Gugic/fanadapter/firmware-stm32/src/protocol.c

// Line-based JSON protocol over the console (USART1 + CDC) — the WebSerial contract. See protocol.h.
//
// Implements config, input/output telemetry, bench tests, direct output, DFU and USB diagnostics.
// get_config is streamed in chunks. Command/event
// shapes match webconfig/src/lib/{serial.ts,types.ts} and Fanadapter.Core/Protocol.cs.
#include "protocol.h"

#include <stdio.h>
#include <string.h>

#include "firmware_info.h"
#include "input_source.h"
#include "json_min.h"
#include "mapping.h"
#include "pedals.h"
#include "stm32h7xx_hal.h" // NVIC_SystemReset
#include "usb_input.h"     // usb_status / usb_kick diagnostics

extern int console_printf(const char *fmt, ...);
// Droppable variants — for the streaming telemetry events only. See console_emit() in main.c.
extern int console_event_printf(const char *fmt, ...);
extern int console_event_write(const char *s);

#define PROTO_VERSION    6 // 6: stream_axes (no-reply set_outputs variant for the PC pedal path)
#define LIVE_PERIOD_MS    33u // ~30 Hz; the console is the bottleneck (USART1 @115200 8E1)
#define OUTPUTS_PERIOD_MS 33u
#define MAX_GLOBAL_SLOTS  16u
#define MAX_TOP_KV        24
#define MAX_BIND_KV       16

static bool     g_live_inputs;
static bool     g_live_outputs;
static bool     g_shadow_connected[MAX_GLOBAL_SLOTS];
static uint32_t g_shadow_change[MAX_GLOBAL_SLOTS];
static uint32_t g_last_live_ms;
static uint32_t g_last_outputs_ms;

// ---------------- small response helpers --------------------------------------------------------
static void send_ok(void) { console_printf("{\"ok\":true}\r\n"); }
static void send_err(const char *msg) { console_printf("{\"err\":\"%s\"}\r\n", msg); }

// Escape a sanitized string for embedding in JSON (copy_string already stripped non-printables).
static void esc(const char *in, char *out, size_t outlen) {
  size_t o = 0;
  for (const char *p = in; *p && o < outlen - 2; p++) {
    if (*p == '"' || *p == '\\') out[o++] = '\\';
    out[o++] = *p;
  }
  out[o] = '\0';
}

// ---------------- type <-> name helpers ---------------------------------------------------------
static const char *input_type_name(uint8_t t) {
  switch (t) {
    case INPUT_BUTTON: return "button";
    case INPUT_AXIS: return "axis";
    case INPUT_HAT: return "hat";
    case INPUT_KEY: return "key";
    default: return "none";
  }
}
static uint8_t input_type_from_name(const char *s) {
  if (!s) return INPUT_NONE;
  if (!strcmp(s, "button")) return INPUT_BUTTON;
  if (!strcmp(s, "axis")) return INPUT_AXIS;
  if (!strcmp(s, "hat")) return INPUT_HAT;
  if (!strcmp(s, "key")) return INPUT_KEY;
  return INPUT_NONE;
}
static const char *gear_mode_name(uint8_t m) { return (m == GEAR_MODE_LATCH) ? "latch" : "hold"; }
static uint8_t     gear_mode_from_name(const char *s) {
  return (s && !strcmp(s, "latch")) ? GEAR_MODE_LATCH : GEAR_MODE_HOLD;
}

// Apply an optional uint16 binding field only when present, so partial set_binding edits are safe.
static void apply_u16(const json_kv *kv, int n, const char *key, uint16_t *dst) {
  long v;
  if (json_get_int(kv, n, key, &v)) *dst = (uint16_t)v;
}

// ---------------- command responses (FIFO-matched to the request) -------------------------------
static void cmd_version(void) {
  console_printf("{\"fw\":\"%s\",\"ver\":\"%s\",\"protocol\":%u,\"max_bindings_per_channel\":%u}\r\n",
                 FW_NAME, FW_VER, PROTO_VERSION, MAX_BINDINGS_PER_CHANNEL);
}

static void cmd_list_devices(void) {
  console_printf("{\"devices\":[");
  bool first = true;
  for (uint8_t si = 0; si < input_source_count(); si++) {
    const InputSource *src = input_source_get(si);
    uint8_t            cnt = src->device_count();
    for (uint8_t i = 0; i < cnt; i++) {
      InputDeviceInfo d;
      if (!src->device_info(i, &d)) continue;
      char mbuf[DEVICE_STR_LEN * 2], pbuf[DEVICE_STR_LEN * 2];
      esc(d.manufacturer, mbuf, sizeof(mbuf));
      esc(d.product, pbuf, sizeof(pbuf));
      console_printf("%s{\"slot\":%u,\"connected\":%s,\"vid\":%u,\"pid\":%u,\"manufacturer\":\"%s\","
                     "\"product\":\"%s\",\"axis_count\":%u,\"button_count\":%u,\"has_hat\":%s,"
                     "\"has_keyboard\":%s}",
                     first ? "" : ",", d.slot, d.connected ? "true" : "false", d.vid, d.pid, mbuf,
                     pbuf, d.axis_count, d.button_count, d.has_hat ? "true" : "false",
                     d.has_keyboard ? "true" : "false");
      first = false;
    }
  }
  console_printf("]}\r\n");
}

// get_config is ~8 KB of JSON — far larger than any single console buffer — so it is STREAMED as
// many small console_printf() chunks (each well under the 256-byte sink buffer). The USART1 leg
// waits for room only when USB is unmounted; with USB mounted it is a best-effort mirror.
// The CDC reply path drains with bounded backpressure (see console_printf).
static void emit_binding(const InputBinding *b) {
  console_printf("{\"vid\":%u,\"pid\":%u,\"type\":\"%s\",\"index\":%u,\"threshold\":%u,\"rawMin\":%u,"
                 "\"rawMax\":%u,\"deadzoneLow\":%u,\"deadzoneHigh\":%u,\"invert\":%s}",
                 b->vid, b->pid, input_type_name(b->type), b->index, b->threshold, b->rawMin,
                 b->rawMax, b->deadzoneLow, b->deadzoneHigh, b->invert ? "true" : "false");
}

static void emit_channel(const ChannelBindings *cb) {
  console_printf("[");
  for (uint8_t i = 0; i < MAX_BINDINGS_PER_CHANNEL; i++) {
    if (i) console_printf(",");
    emit_binding(&cb->bindings[i]);
  }
  console_printf("]");
}

static void cmd_get_config(void) {
  const Config *c = mapping_config();
  console_printf("{\"version\":%u,\"pulseMs\":%u,\"gearMode\":\"%s\",\"max_bindings_per_channel\":%u",
                 c->version, c->pulseMs, gear_mode_name(c->gearMode), MAX_BINDINGS_PER_CHANNEL);

  console_printf(",\"gear\":{");
  for (uint8_t i = 0; i < NUM_GEAR_BINDINGS; i++) {
    ChannelId ch = (ChannelId)(CH_GEAR_R + i);
    console_printf("%s\"%s\":", i ? "," : "", mapping_channel_name(ch));
    emit_channel(&c->gear[i]);
  }
  console_printf("}");

  console_printf(",\"gearOut\":{");
  for (uint8_t i = 0; i < NUM_GEAR_OUTPUTS; i++) {
    ChannelId ch = (ChannelId)(CH_GEAR_R + i);
    console_printf("%s\"%s\":{\"x\":%u,\"y\":%u}", i ? "," : "", mapping_channel_name(ch),
                   c->gearOut[i].x, c->gearOut[i].y);
  }
  console_printf("}");

  console_printf(",\"shift_up\":");
  emit_channel(&c->shiftUp);
  console_printf(",\"shift_down\":");
  emit_channel(&c->shiftDown);
  console_printf(",\"handbrake\":");
  emit_channel(&c->handbrake);
  console_printf(",\"throttle\":");
  emit_channel(&c->throttle);
  console_printf(",\"brake\":");
  emit_channel(&c->brake);
  console_printf(",\"clutch\":");
  emit_channel(&c->clutch);
  console_printf("}\r\n");
}

static void cmd_set_binding(const json_kv *kv, int n) {
  char ch_name[16];
  if (!json_get_str(kv, n, "channel", ch_name, sizeof(ch_name))) {
    send_err("missing_channel");
    return;
  }
  ChannelId ch   = mapping_channel_by_name(ch_name);
  long      slot = 0;
  json_get_int(kv, n, "slot", &slot); // optional, defaults to 0
  if (slot < 0 || slot >= MAX_BINDINGS_PER_CHANNEL) {
    send_err("invalid_slot");
    return;
  }
  InputBinding *b = mapping_binding_slot(ch, (uint8_t)slot);
  if (!b) {
    send_err("unknown_channel_or_slot");
    return;
  }
  const json_kv *bind = json_find(kv, n, "binding");
  if (!bind || bind->type != JSON_OBJ) {
    send_err("missing_binding");
    return;
  }
  json_kv bkv[MAX_BIND_KV];
  int     nb = json_parse_object(bind->val, bind->vallen, bkv, MAX_BIND_KV);
  if (nb < 0) {
    send_err("bad_binding");
    return;
  }
  if (nb > MAX_BIND_KV) nb = MAX_BIND_KV;

  apply_u16(bkv, nb, "vid", &b->vid);
  apply_u16(bkv, nb, "pid", &b->pid);
  char type_name[12];
  if (json_get_str(bkv, nb, "type", type_name, sizeof(type_name)))
    b->type = input_type_from_name(type_name); // "none" -> INPUT_NONE clears the slot
  long idx;
  if (json_get_int(bkv, nb, "index", &idx) && idx >= 0 && idx <= 255) b->index = (uint8_t)idx;
  apply_u16(bkv, nb, "threshold", &b->threshold);
  apply_u16(bkv, nb, "rawMin", &b->rawMin);
  apply_u16(bkv, nb, "rawMax", &b->rawMax);
  apply_u16(bkv, nb, "deadzoneLow", &b->deadzoneLow);
  apply_u16(bkv, nb, "deadzoneHigh", &b->deadzoneHigh);
  int inv = json_get_bool(bkv, nb, "invert");
  if (inv >= 0) b->invert = inv ? 1 : 0;

  mapping_recompute_crc();
  send_ok();
}

static void cmd_set_gear_dac(const json_kv *kv, int n) {
  char ch_name[16];
  if (!json_get_str(kv, n, "channel", ch_name, sizeof(ch_name))) {
    send_err("missing_channel");
    return;
  }
  GearOutputCalibration *g = mapping_gearout_for(mapping_channel_by_name(ch_name));
  if (!g) {
    send_err("not_a_gear_channel");
    return;
  }
  apply_u16(kv, n, "x", &g->x);
  apply_u16(kv, n, "y", &g->y);
  mapping_recompute_crc();
  send_ok();
}

static void cmd_set_pulse_ms(const json_kv *kv, int n) {
  long v;
  if (!json_get_int(kv, n, "value", &v)) {
    send_err("missing_value");
    return;
  }
  mapping_config_mutable()->pulseMs = (uint16_t)v;
  mapping_recompute_crc();
  send_ok();
}

static void cmd_set_gear_mode(const json_kv *kv, int n) {
  char v[12];
  if (!json_get_str(kv, n, "value", v, sizeof(v))) {
    send_err("missing_value");
    return;
  }
  mapping_config_mutable()->gearMode = gear_mode_from_name(v);
  mapping_recompute_crc();
  send_ok();
}

static void cmd_save_config(void) {
  if (mapping_save()) send_ok();
  else send_err("flash_save_failed");
}

static void cmd_reset_config(void) {
  mapping_reset();
  send_ok();
}

static void cmd_live_inputs(const json_kv *kv, int n) {
  int on = json_get_bool(kv, n, "on");
  if (on >= 0) g_live_inputs = (on == 1);
  send_ok();
}

static void cmd_live_outputs(const json_kv *kv, int n) {
  int on = json_get_bool(kv, n, "on");
  if (on >= 0) g_live_outputs = (on == 1);
  send_ok();
}

static void cmd_test_gear(const json_kv *kv, int n) {
  char ch_name[16];
  if (!json_get_str(kv, n, "channel", ch_name, sizeof(ch_name))) {
    send_err("missing_channel");
    return;
  }
  ChannelId ch = mapping_channel_by_name(ch_name);
  if (ch < CH_GEAR_R || ch > CH_GEAR_N) {
    send_err("not_a_gear_channel");
    return;
  }
  mapping_test_gear(ch);
  send_ok();
}

// --- direct output control --------------------------------------------------------------------
// The PC (SimHub / the web app) computes its own mapping and commands the adapter's outputs. These
// override the USB-device mapping for the channels they touch (sticky until release_outputs). set_gear
// and set_outputs are acknowledged and must consume their replies. Only stream_axes is no-reply
// and may use a fire-and-forget write for the protocol-6 pedal/handbrake hot path.
static void cmd_set_gear(const json_kv *kv, int n) {
  char gear[16];
  if (!json_get_str(kv, n, "gear", gear, sizeof(gear))) {
    send_err("missing_gear");
    return;
  }
  ChannelId ch = mapping_channel_by_name(gear);
  if (ch < CH_GEAR_R || ch > CH_GEAR_N) {
    send_err("not_a_gear");
    return;
  }
  mapping_set_gear_override(ch);
  send_ok();
}

static void cmd_set_outputs(const json_kv *kv, int n) {
  long v;
  if (json_get_int(kv, n, "throttle", &v)) mapping_set_axis_override(CH_THROTTLE, (uint16_t)v);
  if (json_get_int(kv, n, "brake", &v)) mapping_set_axis_override(CH_BRAKE, (uint16_t)v);
  if (json_get_int(kv, n, "clutch", &v)) mapping_set_axis_override(CH_CLUTCH, (uint16_t)v);
  if (json_get_int(kv, n, "handbrake", &v)) mapping_set_axis_override(CH_HANDBRAKE, (uint16_t)v);
  send_ok();
}

// No-reply variant of set_outputs for the PC-side pedal hot path (protocol 6). An acked command
// costs a full round-trip per update — measured 7.9 ms over native CDC, capping an ack-waiting
// streamer at ~127 Hz and adding the ack wait as jitter. Pedals deserve neither, so this one
// answers NOTHING: the client fires it at its own fixed rate and never blocks. No reply also
// means it never enters the clients' strictly-FIFO reply matching, so a stream frame can never
// desync command/response pairing. Axes only — gears stay on the acked set_gear (low-rate, and
// the confirmation matters there). Same sticky-override semantics as set_outputs.
static void cmd_stream_axes(const json_kv *kv, int n) {
  long v;
  if (json_get_int(kv, n, "throttle", &v)) mapping_set_axis_override(CH_THROTTLE, (uint16_t)v);
  if (json_get_int(kv, n, "brake", &v)) mapping_set_axis_override(CH_BRAKE, (uint16_t)v);
  if (json_get_int(kv, n, "clutch", &v)) mapping_set_axis_override(CH_CLUTCH, (uint16_t)v);
  if (json_get_int(kv, n, "handbrake", &v)) mapping_set_axis_override(CH_HANDBRAKE, (uint16_t)v);
}

static void cmd_pulse_shift(const json_kv *kv, int n) {
  char dir[8];
  if (!json_get_str(kv, n, "direction", dir, sizeof(dir))) {
    send_err("missing_direction");
    return;
  }
  if (!strcmp(dir, "up")) mapping_pulse_shift(true);
  else if (!strcmp(dir, "down")) mapping_pulse_shift(false);
  else {
    send_err("invalid_direction");
    return;
  }
  send_ok();
}

static void cmd_release_outputs(void) {
  mapping_release_outputs();
  send_ok();
}

// --- test / maintenance (M7) -------------------------------------------------------------------
static void cmd_test_axis(const json_kv *kv, int n) {
  char ch_name[16];
  if (!json_get_str(kv, n, "channel", ch_name, sizeof(ch_name))) {
    send_err("missing_channel");
    return;
  }
  ChannelId ch = mapping_channel_by_name(ch_name);
  if (ch != CH_HANDBRAKE && ch != CH_THROTTLE && ch != CH_BRAKE && ch != CH_CLUTCH) {
    send_err("not_an_axis_channel");
    return;
  }
  long v = 0;
  json_get_int(kv, n, "value", &v); // optional, defaults to 0
  mapping_test_axis(ch, (uint16_t)v);
  send_ok();
}

static void cmd_test_pulse(const json_kv *kv, int n) {
  char dir[8];
  if (!json_get_str(kv, n, "direction", dir, sizeof(dir))) {
    send_err("missing_direction");
    return;
  }
  if (!strcmp(dir, "up")) mapping_test_pulse(true);
  else if (!strcmp(dir, "down")) mapping_test_pulse(false);
  else {
    send_err("invalid_direction");
    return;
  }
  send_ok();
}

// Soft-reset back into this firmware (SYSRESETREQ). Surviving the wheelbase's pedal-UART state, so a
// reset_pedals re-arm is often still needed after — the warmup helps. The ok is flushed first.
static void cmd_reboot(void) {
  send_ok();
  for (volatile uint32_t d = 0; d < 800000u; d++) __NOP(); // let the ok + any CDC FIFO drain
  NVIC_SystemReset();
}

// Reboot into the ROM bootloader (USB DFU on the USB-C) via the token + reset + early-branch path
// in main.c — the CDC port disappears and a DFU device (0483:df11) appears in its place. Used by
// the browser and SimHub firmware flashers. The ok is flushed first — the client's cue to watch for
// the DFU device.
extern void request_bootloader_reboot(void);
static void cmd_dfu(void) {
  send_ok();
  for (volatile uint32_t d = 0; d < 800000u; d++) __NOP(); // let the ok + any CDC FIFO drain
  request_bootloader_reboot();
}

static void cmd_reset_pedals(void) {
  pedals_force_reset();
  send_ok();
}

static void cmd_pedals_status(void) {
  console_printf("{\"state\":\"%s\",\"throttle\":%u,\"brake\":%u,\"clutch\":%u,\"handbrake\":%u}\r\n",
                 pedals_state_name(), pedals_get_throttle(), pedals_get_brake(), pedals_get_clutch(),
                 pedals_get_handbrake());
}

// USB-host pipe diagnostics for the open field bug: a hub device goes silent while still
// enumerated, freezing its last values. These interrogate a freeze in the act. `usb_status`
// snapshots each claimed slot's pipe (busy = transfer outstanding — healthy devices near-always
// are, since a device with nothing to say NAKs; the tell is `age_ms` growing on a device the user
// is actively moving). `usb_kick` aborts + re-arms every claimed pipe: if inputs resume, the wedge
// was host-side (a dwc2 channel stuck busy); if not, the device itself stopped talking. Both
// Commands reply in chunks on the intact console path, like get_config.
// Raw dwc2 host-controller registers on OTG_HS, read directly for the freeze discriminator —
// no TinyUSB internals needed. HCCHAR carries the device address + endpoint each channel is bound
// to, so a frozen slot (matched by "da") can be looked up in the channel dump:
//   ena:0 on its channel  -> Cause A: token post silently swallowed, channel never enabled
//   ena:1 on its channel  -> Cause B: DTERR dead-end (check hcint), or the device itself hung
//   no channel with its da -> Cause C: alloc race orphaned the endpoint
// (candidate causes and code refs: PORT-STATUS "three surviving candidate causes")
// Patched into the vendored hcd_dwc2.c by apply_tinyusb_patches.py:
extern uint32_t tusb_fanadapter_reqq_fail_token;
extern uint32_t tusb_fanadapter_reqq_fail_disable;
extern uint32_t tusb_fanadapter_alloc_mask(void);

#define OTGHS_HPTXSTS   (*(volatile uint32_t *)(USB1_OTG_HS_PERIPH_BASE + 0x410u))
#define OTGHS_HCCHAR(c) (*(volatile uint32_t *)(USB1_OTG_HS_PERIPH_BASE + 0x500u + (c) * 0x20u))
#define OTGHS_HCINT(c)  (*(volatile uint32_t *)(USB1_OTG_HS_PERIPH_BASE + 0x508u + (c) * 0x20u))
#define OTGHS_HOST_CHANNELS 16u

static void cmd_usb_status(void) {
  console_printf("{\"uptime_ms\":%lu,\"slots\":[", (unsigned long)HAL_GetTick());
  bool first = true;
  for (uint8_t i = 0; i < USB_POOL_SIZE; i++) {
    UsbSlotDiag d;
    if (!usb_input_diag(i, &d) || !d.in_use) continue;
    console_printf("%s{\"slot\":%u,\"vid\":%u,\"pid\":%u,\"da\":%u,\"mounted\":%s,\"busy\":%s,"
                   "\"reports\":%lu,\"age_ms\":%lu,\"idle_rearms\":%lu}",
                   first ? "" : ",", i, d.vid, d.pid, d.daddr, d.mounted ? "true" : "false",
                   d.busy ? "true" : "false", (unsigned long)d.reports, (unsigned long)d.age_ms,
                   (unsigned long)d.idle_rearms);
    first = false;
  }
  // hptx: HPTXSTS — low 16 bits = periodic TX FIFO space, bits 16..23 = request-queue space
  // (the silent failures fire when request-queue space reads 0 at a channel-op instant).
  // reqq_fail_*: counters patched into hcd_dwc2.c (apply_tinyusb_patches.py) — nonzero says WHICH
  // queue-full path fired. alloc_mask: which channels the driver believes are allocated — the key
  // for telling a wedged allocated-but-disabled channel from a freed one with stale HCCHAR.
  console_printf("],\"hptx\":%lu,\"reqq_fail_token\":%lu,\"reqq_fail_disable\":%lu,"
                 "\"alloc_mask\":%lu,\"channels\":[",
                 (unsigned long)OTGHS_HPTXSTS, (unsigned long)tusb_fanadapter_reqq_fail_token,
                 (unsigned long)tusb_fanadapter_reqq_fail_disable,
                 (unsigned long)tusb_fanadapter_alloc_mask());
  first = true;
  for (uint8_t c = 0; c < OTGHS_HOST_CHANNELS; c++) {
    uint32_t hcchar = OTGHS_HCCHAR(c);
    if (!hcchar) continue; // never-programmed channel
    console_printf("%s{\"ch\":%u,\"da\":%lu,\"ep\":%lu,\"in\":%u,\"ena\":%u,\"dis\":%u,"
                   "\"hcint\":%lu}",
                   first ? "" : ",", c, (unsigned long)((hcchar >> 22) & 0x7Fu),
                   (unsigned long)((hcchar >> 11) & 0x0Fu), (unsigned)((hcchar >> 15) & 1u),
                   (unsigned)((hcchar >> 31) & 1u), (unsigned)((hcchar >> 30) & 1u),
                   (unsigned long)OTGHS_HCINT(c));
    first = false;
  }
  console_printf("]}\r\n");
}

// Diagnostic reproducer for the freeze's suspected trigger: skip tuh_task() for N ms while the
// rest of the loop (pedals, mapping, console) keeps running — surgically simulating what a long
// main-loop stall does to the USB host stack, without involving the console at all. If repeated
// stalls freeze the streaming pedal on demand, the bug gains a bench reproducer.
extern void usb_host_stall_for(uint32_t ms);
static void cmd_usb_stall(const json_kv *kv, int n) {
  long ms = 1000;
  json_get_int(kv, n, "ms", &ms);
  if (ms < 1) ms = 1;
  if (ms > 10000) ms = 10000;
  usb_host_stall_for((uint32_t)ms);
  console_printf("{\"ok\":true,\"ms\":%ld}\r\n", ms);
}

static void cmd_usb_kick(void) {
  uint32_t aborted = usb_input_kick();
  console_printf("{\"ok\":true,\"aborted_mask\":%lu}\r\n", (unsigned long)aborted);
}

// ---------------- events ------------------------------------------------------------------------
static void emit_attached(const InputDeviceInfo *d) {
  char mbuf[DEVICE_STR_LEN * 2], pbuf[DEVICE_STR_LEN * 2];
  esc(d->manufacturer, mbuf, sizeof(mbuf));
  esc(d->product, pbuf, sizeof(pbuf));
  console_printf(
      "{\"event\":\"device_attached\",\"slot\":%u,\"vid\":%u,\"pid\":%u,\"manufacturer\":\"%s\","
      "\"product\":\"%s\",\"axis_count\":%u,\"button_count\":%u,\"has_hat\":%s,\"has_keyboard\":%s}"
      "\r\n",
      d->slot, d->vid, d->pid, mbuf, pbuf, d->axis_count, d->button_count,
      d->has_hat ? "true" : "false", d->has_keyboard ? "true" : "false");
}

static void emit_detached(uint8_t slot) {
  console_printf("{\"event\":\"device_detached\",\"slot\":%u}\r\n", slot);
}

// The two streaming events go out on the DROPPABLE console path. They are superseded ~30 times a
// second, so losing one when the sink is congested costs nothing — whereas waiting for one costs
// the 100 Hz pedal stream its cadence, which is what used to freeze inputs and make gear changes
// arrive a minute late. Command responses keep using console_printf and still arrive intact.
static void emit_outputs(void) {
  const OutputSnapshot *o = mapping_outputs();
  console_event_printf("{\"event\":\"outputs\",\"gear\":\"%s\",\"shift_up\":%s,\"shift_down\":%s,"
                       "\"throttle\":%u,\"brake\":%u,\"clutch\":%u,\"handbrake\":%u}\r\n",
                       mapping_channel_name(o->gear), o->shiftUp ? "true" : "false",
                       o->shiftDown ? "true" : "false", o->throttle, o->brake, o->clutch,
                       o->handbrake);
}

static void emit_live(const InputLive *lv) {
  // Assembled into ONE buffer and emitted atomically. Each console_event_* call drops
  // independently when congested, so building this line in pieces (as it used to be) could drop a
  // fragment mid-line and put malformed JSON on the wire.
  char b[320];
  int  n = 0;
#define LIVE_APPEND(...)                                                       \
  do {                                                                         \
    if (n < 0 || (size_t)n >= sizeof(b)) return;                               \
    int _r = snprintf(b + n, sizeof(b) - (size_t)n, __VA_ARGS__);              \
    if (_r < 0) return;                                                        \
    n += _r;                                                                   \
  } while (0)

  LIVE_APPEND("{\"event\":\"live\",\"slot\":%u,\"buttons\":%lu,\"axes\":[", lv->slot,
              (unsigned long)lv->buttons);
  for (uint8_t a = 0; a < lv->axis_count && a < INPUT_MAX_AXES; a++)
    LIVE_APPEND("%s%u", a ? "," : "", lv->axes[a]);
  LIVE_APPEND("]");
  if (lv->has_hat) LIVE_APPEND(",\"hat\":%d", (lv->hat == INPUT_HAT_RELEASED) ? -1 : (int)lv->hat);
  if (lv->has_keyboard) {
    LIVE_APPEND(",\"keys\":[");
    for (uint8_t k = 0; k < INPUT_MAX_KEYS; k++) LIVE_APPEND("%s%u", k ? "," : "", lv->keys[k]);
    LIVE_APPEND("]");
  }
  LIVE_APPEND("}\r\n");
#undef LIVE_APPEND

  console_event_write(b);
}

// ---------------- dispatch ----------------------------------------------------------------------
void protocol_handle_line(const char *line) {
  if (line[0] != '{') return; // non-JSON lines are the bring-up CLI (handled in main.c)
  json_kv kv[MAX_TOP_KV];
  int     n = json_parse_object(line, strlen(line), kv, MAX_TOP_KV);
  if (n < 0) {
    send_err("bad_json");
    return;
  }
  if (n > MAX_TOP_KV) n = MAX_TOP_KV;

  char cmd[24];
  if (!json_get_str(kv, n, "cmd", cmd, sizeof(cmd))) {
    send_err("missing_cmd");
    return;
  }

  if (!strcmp(cmd, "version")) cmd_version();
  else if (!strcmp(cmd, "list_devices")) cmd_list_devices();
  else if (!strcmp(cmd, "get_config")) cmd_get_config();
  else if (!strcmp(cmd, "set_binding")) cmd_set_binding(kv, n);
  else if (!strcmp(cmd, "set_gear_dac")) cmd_set_gear_dac(kv, n);
  else if (!strcmp(cmd, "set_pulse_ms")) cmd_set_pulse_ms(kv, n);
  else if (!strcmp(cmd, "set_gear_mode")) cmd_set_gear_mode(kv, n);
  else if (!strcmp(cmd, "save_config")) cmd_save_config();
  else if (!strcmp(cmd, "reset_config")) cmd_reset_config();
  else if (!strcmp(cmd, "live_inputs")) cmd_live_inputs(kv, n);
  else if (!strcmp(cmd, "live_outputs")) cmd_live_outputs(kv, n);
  else if (!strcmp(cmd, "test_gear")) cmd_test_gear(kv, n);
  else if (!strcmp(cmd, "set_gear")) cmd_set_gear(kv, n);
  else if (!strcmp(cmd, "set_outputs")) cmd_set_outputs(kv, n);
  else if (!strcmp(cmd, "stream_axes")) cmd_stream_axes(kv, n);
  else if (!strcmp(cmd, "pulse_shift")) cmd_pulse_shift(kv, n);
  else if (!strcmp(cmd, "release_outputs")) cmd_release_outputs();
  else if (!strcmp(cmd, "test_axis")) cmd_test_axis(kv, n);
  else if (!strcmp(cmd, "test_pulse")) cmd_test_pulse(kv, n);
  else if (!strcmp(cmd, "reboot")) cmd_reboot();
  else if (!strcmp(cmd, "dfu")) cmd_dfu();
  else if (!strcmp(cmd, "reset_pedals")) cmd_reset_pedals();
  else if (!strcmp(cmd, "pedals_status")) cmd_pedals_status();
  else if (!strcmp(cmd, "usb_status")) cmd_usb_status();
  else if (!strcmp(cmd, "usb_kick")) cmd_usb_kick();
  else if (!strcmp(cmd, "usb_stall")) cmd_usb_stall(kv, n);
  else send_err("unknown_cmd");
}

void protocol_init(void) {
  g_live_inputs  = false;
  g_live_outputs = false;
  memset(g_shadow_connected, 0, sizeof(g_shadow_connected));
  memset(g_shadow_change, 0, sizeof(g_shadow_change));
}

void protocol_tick(uint32_t now_ms) {
  // Attach/detach: diff connected state per global slot. Shadows always track; emit only when streaming.
  for (uint8_t si = 0; si < input_source_count(); si++) {
    const InputSource *src = input_source_get(si);
    uint8_t            cnt = src->device_count();
    for (uint8_t i = 0; i < cnt; i++) {
      InputDeviceInfo d;
      if (!src->device_info(i, &d) || d.slot >= MAX_GLOBAL_SLOTS) continue;
      if (d.connected != g_shadow_connected[d.slot]) {
        g_shadow_connected[d.slot] = d.connected;
        if (g_live_inputs) {
          if (d.connected) emit_attached(&d);
          else emit_detached(d.slot);
        }
      }
    }
  }

  // Live outputs — current output snapshot, rate-limited.
  if (g_live_outputs && (uint32_t)(now_ms - g_last_outputs_ms) >= OUTPUTS_PERIOD_MS) {
    g_last_outputs_ms = now_ms;
    emit_outputs();
  }

  if (!g_live_inputs || (uint32_t)(now_ms - g_last_live_ms) < LIVE_PERIOD_MS) return;
  g_last_live_ms = now_ms;
  for (uint8_t si = 0; si < input_source_count(); si++) {
    const InputSource *src = input_source_get(si);
    uint8_t            cnt = src->device_count();
    for (uint8_t i = 0; i < cnt; i++) {
      InputLive lv;
      if (!src->device_live(i, &lv) || !lv.connected || lv.slot >= MAX_GLOBAL_SLOTS) continue;
      if (lv.change_seq != g_shadow_change[lv.slot]) {
        g_shadow_change[lv.slot] = lv.change_seq;
        emit_live(&lv);
      }
    }
  }
}
