Gugic/fanadapter/(commit log)

2026-05-22 Working pedals end-to-end on DD+; SP Pro HID; doc cleanup
    Pedal handshake (pedals.cpp):
    - Replace strict-linear Step 2 matcher with a lenient any-order
    packet collector. The DD+ firmware sends the three Step 2 query
    packets (cmd 0x00, 0x02, 0x03) in arbitrary order, sometimes
    dozens of times each, and with a different 0x02 payload than
    the GeekyDeaks/proxy.go reference. Strict matching never
    completes; matches the community sketch in GeekyDeaks#4.
    - Per-query streaming responses instead of one 36-byte bulk write.
    Each cmd gets its 12-byte ack the instant it's recognized.
    - Transition to STREAMING after the cmd 0x03 ack (the version-
    identity packet) rather than waiting for all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
    [pedals.cpp, pedals.h]
2026-05-26 Runtime-configurable mappings, WebSerial config UI, multi-input per channel
    Firmware (shifter_test/):
    - Split the monolithic .ino into device_pool / mapping / protocol modules;
    pedals.cpp remains the CSL Elite V2 UART emulator.
    - 1060-byte Config struct persisted to EEPROM with CRC-32/ISO-HDLC,
    static_assert-locked layout, CONFIG_VERSION = 2.
    - Each of the 14 output channels (8 gears, 2 sequential, handbrake,
    3 pedals) now carries up to MAX_BINDINGS_PER_CHANNEL = 4 input bindings;
    buttons OR together, axes MAX together. Cross-type aware: axis-as-button
    via post-scale threshold, button-as-axis emits 0/65535.
    - JSON command protocol over USB CDC: version, list_devices, get_config,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
    [device_pool.cpp, device_pool.h, mapping.cpp, mapping.h, pedals.cpp, pedals.h, protocol.cpp, protocol.h]
2026-05-26 Rename shifter_test/ to firmware/
    The original prototype name no longer reflects the project (which covers
    pedals, sequential, handbrake, and the WebSerial config story, not just
    H-shifter testing). All paths git-mv'd so history follows; .ino renamed
    to firmware.ino to keep the Arduino sketch/folder-name convention. Two
    README references updated.
    [device_pool.cpp, device_pool.h, firmware.ino, mapping.cpp, mapping.h, pedals.cpp, pedals.h, protocol.cpp]
2026-05-26 Add AI coding-agent instructions (AGENTS.md, CLAUDE.md)
    AGENTS.md is the canonical agent guide: repo layout, firmware module map, cross-file invariants (firmware <-> webconfig), channel model, capture flow, serial protocol queue, and a checklist of things agents should know before editing. CLAUDE.md is a pointer so Claude Code loads it automatically.
    .gitignore: add .antigravitycli/ alongside the existing .claude/ entry — both are local AI-agent session artifacts that should stay out of version control.
2026-05-26 Fix multi-binding overwrite bug by replacing strict ArduinoJson is<uint8_t/uint16_t> checks with robust is<int>
    On the Teensy compiler and with this version of ArduinoJson, calling .is<uint8_t>() or .is<uint16_t>() strictly checks type traits or can fail to match JSON integer storage. Specifically, this caused doc["slot"].is<uint8_t>() to return false, defaulting slot to 0 on every set_binding call. As a result, mapping a trigger to slot 1, 2, or 3 silently overwrote slot 0, making it look like the firmware only caught the last mapped trigger.
    Replacing all sub-word integer .is<uint8_t>() and .is<uint16_t>() checks in protocol.cpp with the standard and compiler-independent .is<int>() check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
    [protocol.cpp]
2026-05-26 Add custom USB descriptors to rename device to Fanadapter v0.3.0
    Added name.c inside the firmware folder, utilizing Teensyduino's usb_names.h to override the weak USB manufacturer and product string descriptors. This replaces the generic "USB Serial (COM11)" name with Manufacturer: "fanadapter" and Product: "Fanadapter v0.3.0" (matching the current firmware version).
    Updated AGENTS.md and firmware/README.md to document the addition of the name.c translation unit in the module architecture list.
    [name.c]
2026-05-26 Fix Teensy USB name override by adding PROGMEM to descriptor structures
    Without PROGMEM, the compiler puts the custom structures in standard RAM instead of flash memory, which fails to match the core usb_names.h declarations and prevents the weak symbols from being successfully overridden at link time.
    [name.c]
2026-05-26 Add Gamepad and Multi-axis Controller support to the device pool
    Added support for TOPUSAGE_GAMEPAD (0x10005) and TOPUSAGE_MULTIAXIS (0x10008) in device_pool.h/cpp, letting the GenericJoystickHID slots claim standard gamepads (such as Xbox, PlayStation, or generic controllers) and multi-axis devices in addition to generic joysticks.
    Updated AGENTS.md and firmware/README.md to reflect gamepad/controller support.
2026-05-26 Implement multi-device HID collection logging to capture diagnostic info
    Replaced the single-field unhandled device tracker with a robust, thread-safe circular buffer (up to 16 entries) inside device_pool.cpp. The USB Host task now silently registers all observed HID collections (both whitelisted and vendor-specific) to this buffer during device enumeration.
    The main loop thread (inside protocolTick() in protocol.cpp) safely polls, prints, and clears the logged entries to the Serial CDC output whenever a connection is active. This avoids any re-entrant locks on the USB hardware while ensuring we capture all HID collections for the DualSense controller.
    [device_pool.cpp, device_pool.h, protocol.cpp]
2026-05-27 Add D-pad, keyboard, and latch-mode H-pattern input support (#2)
    Expands the input layer beyond joysticks/gamepads with two new first-class
    input types and a stateful H-pattern mode for momentary controllers.
    Firmware:
    - INPUT_HAT: gamepad D-pad / Hat Switch decoded as a first-class direction
    value (0..7, HAT_RELEASED=0xFF), not virtual buttons. Bindings match a
    strict direction; diagonals don't fire cardinal bindings. evalAxis /
    evalButton handle it with invert support.
    - INPUT_KEY: claim USB keyboards (topusage 0x10006) into the device pool,
    track up to MAX_KEYS_PRESSED (6) pressed scancodes, bind any key
    (incl. modifiers 0xE0..0xE7) via the normal Listen flow.
    - H-pattern hold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
    [device_pool.cpp, device_pool.h, firmware.ino, mapping.cpp, mapping.h, protocol.cpp]
2026-05-27 Restructure and organize project documentation (#1)
    * docs: restructure repository documentation
    - Created high-level root README.md with system overview, compatibility, layout, roadmap, references, and license.
    - Created schematics/README.md for hardware port pinouts, protocols, BoM, step-by-step assembly, and block diagrams.
    - Refined firmware/README.md to focus on compiling/flashing, loop dispatch module layout, internal logic, serial diagnostic CLI, and JSON API reference.
    - Refined webconfig/README.md to focus on React/Vite development, three-phase capture flow, FIFO serial queue, cross-file invariants, and presets config.
    * docs: fold D-pad/keyboard/latch inputs into restructured ref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
2026-05-27 Device names in enumeration + streamlined mapping UI (#3)
    * feat: surface USB device names in enumeration
    Capture each device's USB manufacturer/product string descriptors at
    claim time (sanitised to printable ASCII so the protocol JSON stays
    valid UTF-8) and emit them in list_devices and device_attached. The
    strings are read straight from dev->strbuf, which enumeration populates
    before claim_collection() runs, so binding mydevice plus the inherited
    product() accessor is enough.
    Lets the configurator label devices by name instead of raw VID/PID.
    * feat: streamline webconfig mapping UI
    - Show device names (manufacturer/product) on device cards and in
    binding summaries, falling back to V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
    [device_pool.cpp, device_pool.h, firmware.ino, protocol.cpp]
2026-05-28 chore: drop orphan preset file + corresponding README section (#14)
    webconfig/public/presets/rs-shifter-rs-combo-spu-spro.json was never
    loaded by any code — no fetch, no import, no UI surface. The README
    described public/presets/ as 'Pre-bundled JSON configurations loaded
    via fetch' but that loading code was never written. This PR was even
    growing the file (196+/14-) without anything consuming it.
    Drops both the file and the corresponding README section (the public/
    directory listing and the 'Presets Config Layout' / 'Standard Presets'
    sections). If we ever wire up preset loading, the file can come back
    alongside the code that consumes it.
2026-07-20 STM32H743 port: full-parity C firmware with native USB webconfig (#22)
2026-07-20 STM32: record full end-to-end validation on the WeAct H743VIT6 (#23)
2026-07-20 docs: split the STM32 port docs into a build guide and a dev record (#24)
2026-07-21 STM32: watchdog for silently dropped HID report pipes
    Field symptom: after a few minutes the USB pedals stopped delivering input
    while still listed as connected; every other hub device kept working; only a
    reboot recovered it, and only for a few minutes.
    TinyUSB never re-arms a report pipe itself — the only thing keeping a device
    polling is the tuh_hid_receive_report() call at the end of the report
    callback, and that call can fail transiently (endpoint claim / host channel
    allocation). Both call sites ignored the return value, so a single failure
    permanently silenced the device while the pool slot, list_devices and the
    mount state all stayed healthy. It hits the pedals first because analo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
    [main.c]
2026-07-21 STM32: make hands-free DFU entry actually work (token + reset + early branch)
    The advertised "hands-free" dfu console command had never been validated and
    wedged the board every time: it clock-gated the OTG controllers and branched
    to the ROM from the running app. The clock gate froze the D+ pullup latched
    high, so the host never saw a detach — Windows kept a zombie COM port that
    failed opens with "device not functioning" — and no DFU device ever appeared.
    Only an RST tap recovered.
    Bisected on hardware: a late software branch into the H7 ROM serves NO
    interfaces at all. Not USART (June, FK743M3 — previously mistaken for
    "USB-only mode") and not USB DFU either: adding a proper tud_dis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
    [main.c]
2026-07-21 STM32: stop logging from the main loop; record the real cause of input freezes
    The watchdog added in #26 aimed at the wrong failure, and the field
    evidence says the whole USB-host theory was wrong.
    What actually starves the adapter is console_printf. It does a blocking
    HAL_UART_Transmit per line whether or not anything is attached to USART1,
    and the live/outputs telemetry events are emitted through it: ~5.5 ms per
    live line and ~10.5 ms per outputs line at 115200 8E1, with inputs at up
    to ~30 Hz and outputs streaming continuously. With both streams enabled —
    which is exactly what webconfig and the SimHub plugin do on connect — over
    half of every second is spent blocked, in a loop where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
    [main.c]
2026-07-21 STM32: JSON {"cmd":"dfu"} — reboot to bootloader as a protocol command
    The dfu console verb becomes reachable as a JSON command so clients can
    drive a firmware update without a terminal: ok is flushed first (the
    client's cue to start watching USB for the DFU device), then the token +
    reset + early-branch path runs. STM32-only by nature; the Teensy answers
    unknown_cmd, same as the direct-output commands.
    Hardware-validated on COM10: {"cmd":"dfu"} -> {"ok":true} -> CDC drops ->
    "DFU in FS Mode" enumerates.
    [main.c, protocol.c]
2026-07-21 webconfig: one-click firmware updates, with the Pages deploy as the channel
    The header's Flash button opens an updater that runs the whole cycle from
    one press: fetch the published image, reboot the adapter into its ROM
    bootloader over serial, find the DFU device through the persisted WebUSB
    grant, erase/write/boot over DfuSe (src/lib/dfu.ts), reconnect through the
    persisted WebSerial grant, confirm the new version. Chromium's device
    picker appears exactly once per machine — requestDevice() needs a fresh
    user gesture and the grant persists — so it lives on its own clearly
    labelled button and every later update is hands-free. Running the update
    disconnected is allowed on purpose: a board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
2026-07-21 SimHub plugin: one-click firmware updates over WinUSB
    The webconfig updater's C# twin, one step more hands-free: native code has
    no WebUSB permission model, so there is no device picker even on the first
    run. "Update firmware" in the ADAPTER section fetches the same published
    build the site serves (FirmwareChannel, overridable via the FirmwareUrl
    setting for forks), sends {"cmd":"dfu"}, releases the COM port, opens the
    ROM bootloader over WinUSB, flashes, waits for the port to re-enumerate
    and reconnects through the normal connect path so telemetry comes back
    armed. Update-while-disconnected is allowed for bootloader-stranded
    recovery, same as webconfig.
    DfuseFlasher is the third DfuSe impl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
2026-07-21 SimHub plugin: flash a local .bin, not only the published build
    The updater could only install what the Pages deploy served, which is
    useless while that deploy does not exist yet — the repo is private, so
    there is no published build to fetch and the button sat disabled.
    Browse .bin… picks a local image, validated at pick time with the same
    suffix strip and vector-table check the download path uses, and takes
    priority over the channel when set. The button relabels to "Flash
    <file>" so it always says which source it will use, and the status line
    shows the picked file instead of the unavailable "latest". Everything
    after image selection is the unchanged flow: dfu -> WinUSB -> flash ->
    reco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
2026-07-21 SimHub plugin: render adapter devices when the session connected before the UI
    The Devices tab was permanently empty on a normal start — no device cards
    and no live input — while the Outputs tab worked fine.
    AdapterSession raises DevicesChanged from ConnectAsync, but with
    AutoConnect enabled that runs inside Init(), long before SimHub builds
    the settings control. The event fired with nothing subscribed. When the
    view model was constructed afterwards it called SyncFromSession, which
    rebuilt the mapping and output editors from session state but not the
    device list — so Devices stayed empty forever. Every live frame was then
    discarded in ApplyPendingLive, whose Devices.FirstOrDefault ret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
2026-07-21 STM32: interrupt-driven console so telemetry can't starve the pedal stream
    Console writes used to transmit inline, and the live/outputs events go
    through the same path: ~5.5 ms per live line and ~10.5 ms per outputs
    line at 115200 8E1. With both streams enabled — what every client turns
    on at connect — over half of every second was spent blocked, in a loop
    where pedals_update() runs last and needs a 10 ms cadence. That is the
    cause identified in #28: inputs froze at their last values, gear changes
    arrived up to a minute late, and the pedal link cycled RX error burst ->
    re-handshake.
    USART1 output now goes through an interrupt-driven TX ring drained by the
    TXE half of USART1_IRQHandler,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
    [main.c, protocol.c]
2026-07-21 Wire integrity + freeze diagnostics for the STM32 console and both clients
    Three field failures from one night on the rig, all diagnosed from logs:
    - A lossy console write could emit a PARTIAL line when the CDC FIFO
    filled mid-write: a truncated outputs event glued to the next intact
    reply destroyed both, and the clients' strictly-FIFO reply matching
    went permanently one-behind (every request timed out, every reply
    arrived "stale"). Lossy writes on both legs are now whole-line-or-
    nothing.
    - SerialClient now self-heals from wire corruption regardless: two
    consecutive stale absorptions with no success between them send a
    `version` probe and realign the queue on its uniquely-sh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
    [main.c, pedals.c, protocol.c]
2026-07-21 Root-cause the input freeze: the pedal hangs when unpolled ~2 s; keep gaps under 120 ms
    The "one hub device goes silent while still enumerated" bug is closed.
    The terminal mechanism is the Simnet pedal's own firmware: starve it of
    IN polls for ~2 seconds mid-stream and its USB endpoint wedges until
    re-enumeration. Measured with a threshold sweep (usb_stall): survives
    1.6 s, degrades from 600 ms, dies at 2.0 s. Older adapter firmware
    really did create such gaps (console starvation era, the 720 ms connect
    stall, CDC interrupt pressure); current firmware's worst measured gap
    is ~120 ms - a 13x margin.
    Getting there took instrumentation, a reproducer, and three real-but-
    not-causal driver bugs,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
    [apply_tinyusb_patches.py, main.c, protocol.c, tusb_config.h]
2026-07-21 PC pedal precision: stream_axes, a no-reply set_outputs twin (protocol 6)
    PC-attached pedals rode an acked command per update: 7.9 ms round-trip
    measured (13 ms before the console fixes), which caps a reply-waiting
    streamer at ~127 Hz and injects the ack wait into every update as
    jitter. Pedals deserve one-way latency and a fixed cadence.
    - Firmware: stream_axes - identical semantics to set_outputs' axis
    half, but answers NOTHING. Because no reply exists, it never enters
    the clients' strictly-FIFO reply matching, so a stream frame can
    never desync command/response pairing no matter how it interleaves
    with acked traffic. Gears stay on the acked set_gear. PROTO_VERSION
    5 -> 6.
    - Fan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
    [protocol.c]
2026-07-24 SimHub drive: Detect button auto-configures each pedal axis
    Configuring PC pedals meant hunting a property name out of a 500-entry
    combo box, then guessing the range and direction. Now: click Detect,
    press the pedal, done.
    PropertyAxisDetector (Fanadapter.Core, clock-free, 8 tests): the
    adapter-side CaptureEngine watches one device's frames, but on the PC
    side "which property is my brake" is exactly the unknown - so this one
    watches EVERY property SimHub publishes. Same three-phase shape as
    webconfig's Listen, adapted to properties of arbitrary unknown scale:
    - Baseline (~0.6 s): per-property noise floor; anything already moving
    is excluded outright, which silently drops live game teleme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
2026-07-25 Docs: STM32 JSON command reference + root README reflects STM32/SimHub/flashing
    The STM32-only commands (set_gear/set_outputs/stream_axes/pulse_shift/
    release_outputs, pedals_status, dfu, usb_status/usb_kick/usb_stall) had
    no reference table anywhere — the Teensy firmware/README table correctly
    omits them since the Teensy answers unknown_cmd, but firmware-stm32
    listed only dfu/reboot in prose. Add a command table (new section 6) so
    they aren't source-only. Root README opening line still framed the
    project as Teensy-only and the webconfig blurb omitted the one-click
    firmware updater; both corrected.
2026-07-25 Docs: mark the Teensy firmware archived, STM32 as the active build
    The Teensy sketch is no longer developed — everything added since the
    port (PC/SimHub direct output, dfu flashing, USB diagnostics) is
    STM32-only. Banner in firmware/README.md, notes in the root README
    layout + block diagram, AGENTS component bullet and commands heading,
    and firmware-stm32/README.md reframed from "alternative to the Teensy"
    to the build you should actually make.
    Deliberately NOT deprecating firmware/README.md itself: it stays the
    canonical shared reference for the JSON API, Config schema, channel
    model, calibration and RJ12 wiring, which the STM32 docs link into
    rather than duplicate. AGENTS now says so ex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
2026-07-25 CI: fix high-severity npm advisories (eslint 10 + postcss)
    npm audit --audit-level=high started failing on two newly-published
    advisories, both dev-only and unrelated to any code change:
    - brace-expansion <=5.0.7 (GHSA-mh99-v99m-4gvg). No patched 1.x exists,
    and forcing 5.0.8 via an overrides block CRASHES eslint 9 —
    @eslint/config-array blows up in pathMatches, because that minimatch
    expects the 1.x API. Verified locally before trusting it. The only
    real fix is eslint 10, which resolves the chain natively.
    - postcss <=8.5.17 (GHSA-r28c-9q8g-f849) -> 8.5.23.
    eslint 10 needs eslint-plugin-react-hooks >=6 (v5 peer-caps at eslint 9),
    and v7 ships new rules that flag 9 PRE-EXISTING A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
2026-07-25 Docs: promote firmware-stm32 to source of truth for the shared contracts
    The Teensy sketch is archived, so the cross-file invariants table now
    leads with the STM32 files (src/mapping.{c,h} with scale_axis,
    src/protocol.c) and carries the Teensy paths in a fourth 'archived
    mirror' column rather than as the reference. Also records what the split
    means in practice: the Config layout is static_assert-locked to the same
    1132 bytes on both builds, the STM32 is protocol 6 while the Teensy
    stayed at 5, and clients must feature-gate (SupportsDirectOutput /
    SupportsAxisStreaming / SupportsDfu) instead of assuming.
2026-07-25 Fix the react-hooks findings in App.tsx; rules back to error
    Follows the eslint 10 upgrade, which surfaced 9 pre-existing findings.
    All fixed, and both rules are back at their default 'error'.
    - 6x prop->draft mirroring (number fields, pulse-ms, threshold slider,
    deadzone range slider, both gear DAC inputs) went through
    `useEffect(() => setLocal(value), [value])`, which paints the stale
    draft and only then re-renders. Replaced with a `useDraft` helper
    doing React's documented render-time adjustment against the previous
    source. The range slider passes a joined "low:high" key because its
    draft is a fresh array every render and would otherwise re-seed
    forever.
    - The recalibration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
2026-10-13 Publish independent firmware and plugin releases with verified updates
    Restore versioned native USB labels and filter adapter connections by VID/PID. Keep firmware 0.6.1 separate from plugin 0.1.1; Pages mirrors released firmware without building it. Add plugin release checks and a verified two-DLL installer with restart recovery. Config schema and protocol remain unchanged.
2026-10-30 fix(simhub): tolerate WMI port-name lookup failures
    Prevent an optional Windows device-name lookup failure from aborting serial-port discovery.
    PortLocator.BusReportedName() can throw InvalidOperationException while querying device properties through System.Management.ManagementObject.InvokeMethod().
    Handle the lookup failure and allow port enumeration to continue using the available fallback naming behavior.
    This fixes both plugin settings initialization and manual port refresh when Windows encounters a device whose bus-reported name cannot be retrieved.
2026-10-30 chore(simhub): bump VersionPrefix
    Caught by Github Actions:
    ```
    ...
    From https://github.com/Gugic/fanadapter
    * tag simhub-v0.1.2 -> FETCH_HEAD
    Exception: D:\a\_temp\c4d449b5-4682-4661-8e9c-16d4580c0d65.ps1:9
    Line |
    9 | … DE -ne 0) { throw "Plugin code changed since $tag. Bump VersionPrefix …
    | ~~~~~~~~~~~~~~~~~~~~~~~~~~~~~~~~~~~~~~~~~~~~~~~~~~~~~~~~~
    | Plugin code changed since simhub-v0.1.2. Bump VersionPrefix in Directory.Build.props.
    Error: Process completed with exit code 1.
    ...
    ```
    Documented already:
    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
